vayun07/Robot-to-aid-bedridden-patients/README.md

# Robot to aid bedridden patients

The robot to help bedridden persons will comprise of the following concepts:

 Remote control system of robot with a mobile phone through WIFI network

 Autonomous control system of robot through a line following system

 Ultrasonic sensors

 Distance sensor

 IP camera

 Drive system

 WIFI system (Adafruit module)

 Microcontrollers



**Semi-automatic System**




**WiFi Bot Control**
